voncloft/Macropad/Macropad/back.jpg

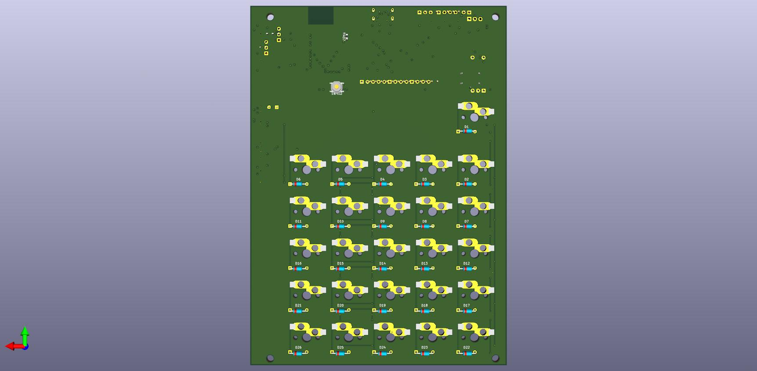
Macropad/back.jpg
