voncloft/Macropad/README.md

Hopefully a simple project to push thru on March 31st 2026

A macropad with Wifi, Bluetooth, IR TX and RX, and battery operated
