voncloft/Macropad/Macropad/REV_B_PIN_ASSIGNMENT.txt

REV-B Proposed Pin Assignment (First Pass)
Generated: 2026-03-01

RGB data in: pad 23 (existing signal now named RGB_DATA) -> net RGB_DATA
Hall analog in: pad 35 (currently NC) -> net HALL_OUT
Display bus: keep existing LCD_MOSI/LCD_SCLK nets on pads 33/34
LCD control: pads 36/37/38/39 -> LCD_CS/LCD_DC/LCD_RST/LCD_BL
Touch (I2C, repurposed from old SPI-touch nets): pad 24 -> TOUCH_SDA, pad 26 -> TOUCH_SCL
Shared SPI MISO return: pad 25 -> SPI_MISO
SD card (shared SPI): pad 27 -> SD_CS
Encoder: keep existing ENC_A/ENC_B/ENC_SW on pads 30/31/32

Reserved NC pads for future use: 8, 9, 10, 11, 13, 14, 15, 16

Notes
- Final GPIO legality must be cross-checked against ESP32-S3 strapping/boot constraints.
- Display + SD shared SPI bus plan:
- SD card: SCK=LCD_SCLK, MOSI=LCD_MOSI, MISO=SPI_MISO, CS=SD_CS.
- Touch controller (#2090 I2C): SDA=TOUCH_SDA, SCL=TOUCH_SCL.
- If pad 35 ADC mapping is unsuitable, move hall to one of: 8, 9, 10, 11, 13, 14, 15, 16.
- Power/current firmware limits must be enabled before high-brightness RGB tests.
