voncloft/Macropad/case/keyboard-layout.png

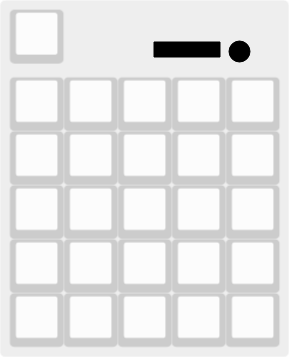
case/keyboard-layout.png
