voncloft/Macropad/case/Screenshot_20260228_230614.png

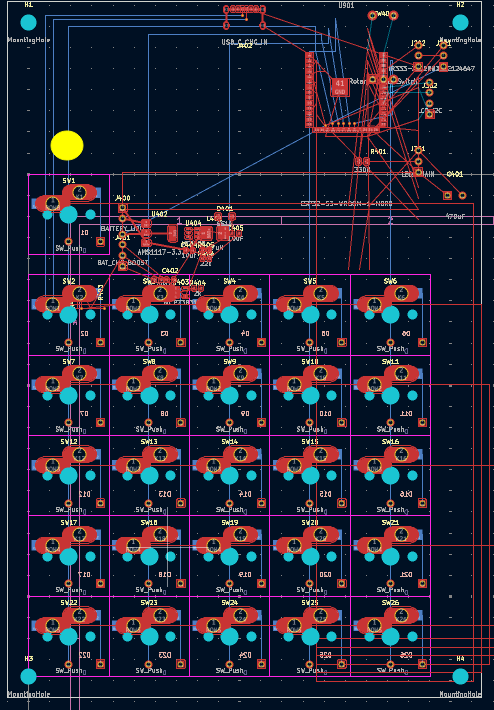
case/Screenshot_20260228_230614.png
