voncloft/Macropad/Macropad/live_board_render.png

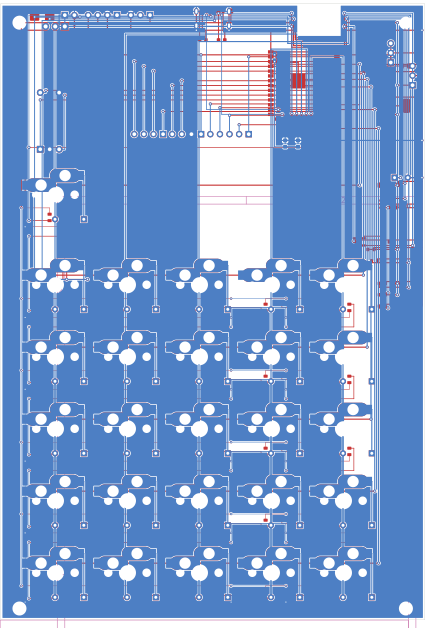
Macropad/live_board_render.png
