voncloft/Macropad/macropad.ods

Sheet: Parts
Category | Part | Qty | Unit Price (USD) | Line Total (USD) | URL | Notes
Required | Cherry MX Switch Set (35 switches) | 1 | 19.99 | 19.99 | https://www.keychron.com/products/cherry-switch-set | Hot-swap switches for 26-key build (buy 1x 35-pack)
Required | DSA Clear 1U Blank Keycap Set (10 pcs) | 3 | 5.7 | 17.1 | https://shop.beekeeb.com/product/dsa-clear-1u-blank-keycap-set-for-mx-switch/ | 3 packs gives 30 keys for 26-key build; flat DSA profile
Required | OLED LCD module (0.91in, 128x32, I2C) | 1 | 34.95 | 34.95 | https://www.adafruit.com/product/2090 | Matches display spec in project notes
Required | LiPo battery 3.7V 2500mAh | 1 | 14.95 | 14.95 | https://www.adafruit.com/product/328 | Power pack for portable build
Required | MSS-102545-14A-V-SMT mini slide switch | 1 | 1.88 | 1.88 | https://www.digikey.com/en/products/detail/same-sky-formerly-cui-devices/MSS-102545-14A-V-SMT/13978953 | Inline battery power switch
Required | Rotary knob, 6mm D-shaft compatible | 1 | 2.95 | 2.95 | https://www.adafruit.com/product/5531 | Fits 6mm shaft rotary encoder with set screw
Required | M3 screw + standoff kit | 1 | 16.95 | 16.95 | https://www.adafruit.com/product/4685 | Case/board mounting hardware
Required | 22AWG stranded hookup wire set (6 x 25ft) | 1 | 19.95 | 19.95 | https://www.adafruit.com/product/3111 | Battery/switch/LCD wiring
Required | Solder spool (100g) | 1 | 14.95 | 14.95 | https://www.adafruit.com/category/product/145 | Through-hole and wire soldering
Required | USB-C to USB-C cable, 3ft | 1 | 3.88 | 3.88 | https://www.walmart.com/ip/ONN-TYPE-C-CABLE/14834760762 | Power/data cable
Required | Adjustable 30W 110V soldering iron | 1 | 22 | 22 | https://www.newark.com/adafruit/180/adjustable-30w-110v-soldering/dp/54W2651 | For assembly and wiring
Required | Soldering Kit (iron + stand + tips + wick + sucker + tweezers + flux) | 1 | 29.99 | 29.99 | https://www.amazon.com/dp/B07Q2B4ZY9 | Complete kit for assembly/rework (replace separate iron if preferred)
Optional | Digital multimeter | 1 | 17.5 | 17.5 | https://www.adafruit.com/product/2034 | Voltage/continuity checks during bring-up
Required | 3mm LEDs (diffused) | 30 | 0.2 | 6 | https://www.adafruit.com/product/777 | Adafruit 3mm diffused red LEDs: $4.95 per 25-pack (~$0.198 each)
Required | Pin pusher for reset | 1 | 9.2 | 9.2 | https://www.centurytools.com/product/press-fit-spring-plunger-27/
 | Male to female jumpers | 1 | 1.51 | 1.51 | https://www.aliexpress.us/item/2251832638768791.html?src=google

Sheet: JLCPCB
JLCPCB Item | Qty | Est Unit (USD) | Line Total (USD) | URL | Notes
PCB fabrication (5 pcs, 2-layer) | 1 | 24 | 24 | https://jlcpcb.com/quote | PCB fab by JLCPCB
PCBA assembly add | 1 | 200 | 200 | https://jlcpcb.com/pcb-assembly | User-requested +200 assembly
ESP32-S3-WROOM-1 module | 1 | 4.9 | 4.9 | https://www.lcsc.com/product-detail/C2913201.html | Main MCU
Kailh hotswap socket | 26 | 0.11 | 2.86 | https://www.lcsc.com/product-detail/C41430893.html | Onboard sockets
Diode DO-35 | 26 | 0.02 | 0.52 | https://www.lcsc.com/product-detail/C85057.html | Matrix diodes
Resistor 0603 | 5 | 0.01 | 0.05 | https://www.lcsc.com/product-detail/C25803.html | From footprint count
Resistor 0805 | 1 | 0.01 | 0.01 | https://www.lcsc.com/product-detail/C17630.html | From footprint count
Capacitor 0603 | 4 | 0.01 | 0.04 | https://www.lcsc.com/product-detail/C19702.html | From footprint count
SOD-123 diode | 1 | 0.03 | 0.03 | https://www.lcsc.com/product-detail/C2480.html | Power path
Inductor 5x5 | 1 | 0.28 | 0.28 | https://www.lcsc.com/product-detail/C354596.html | Boost section
Electrolytic cap radial | 1 | 0.12 | 0.12 | https://www.lcsc.com/product-detail/C3035350.html | Power filtering
SOT-223 | 1 | 0.15 | 0.15 | https://www.lcsc.com/product-detail/C6186.html | Power IC/transistor
SOT-23-5 | 1 | 0.09 | 0.09 | https://www.lcsc.com/product-detail/C424093.html | Power/control
SOT-23-6 | 1 | 0.08 | 0.08 | https://www.lcsc.com/product-detail/C84817.html | Power/control
USB-C receptacle | 1 | 0.48 | 0.48 | https://www.lcsc.com/product-detail/C3151650.html | USB connector
Pin headers total (includes IR module mounts) | 6 | 0.25 | 1.5 | https://www.lcsc.com/product-detail/C49257.html | 1x2/1x3/1x4 total
Rotary encoder EC11 | 1 | 0.65 | 0.65 | https://www.lcsc.com/product-detail/C361165.html | Onboard encoder

Sheet: Summary
Summary Item | Value (USD) | Notes
Parts Autosum | 233.75 | Excel-style pull from Parts autosum label
JLCPCB Autosum | 235.76 | Excel-style pull from JLCPCB autosum label
Autosum (Summary Page) | 469.51 | Final total
Switch Wiring Note | Solder required | Battery+ -> switch -> BAT+, battery- direct to GND
