voncloft/Macropad/case_reworking/macropad_case_assembled.stl

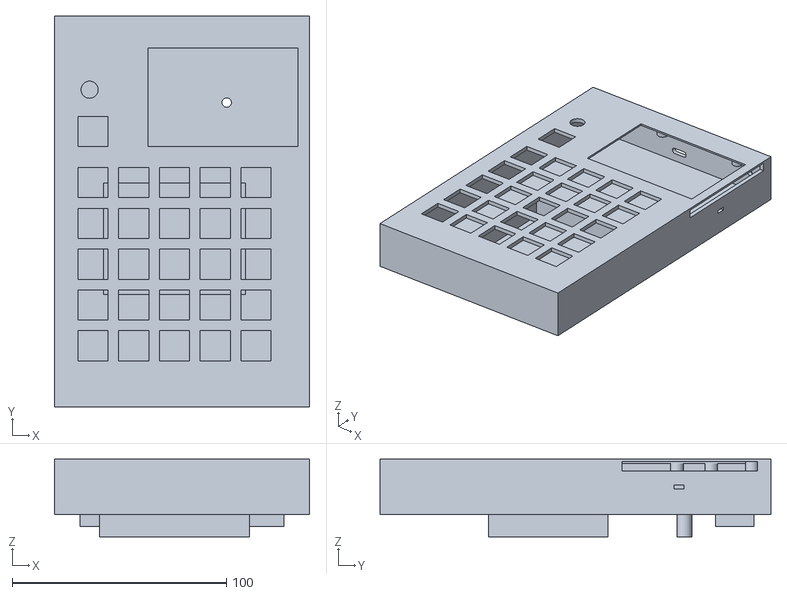
[picture p5: CAD file, 2026-03-06]
case_reworking/macropad_case_assembled.stl
119.1 x 182.5 x 36.4
