voncloft/Macropad/case/macropad_case_assembled.stl

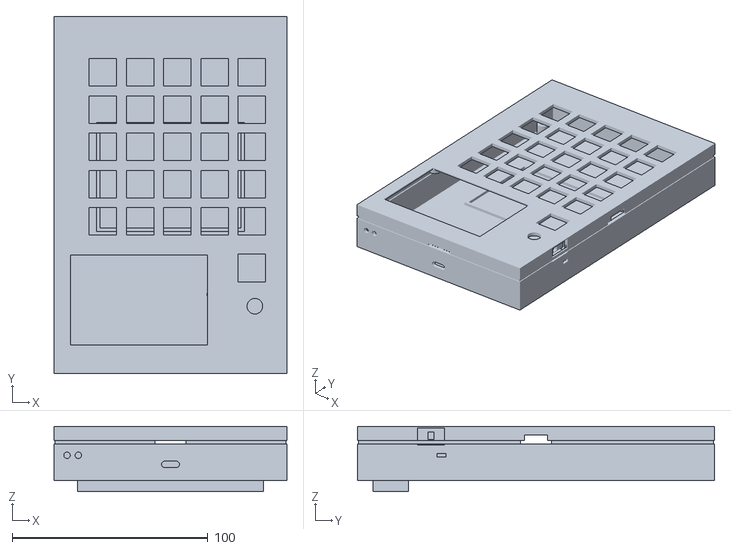
[picture p6: CAD file, 2026-03-04]
case/macropad_case_assembled.stl
119.1 x 182.5 x 33.4
