voncloft/Macropad/case/macropad_case_side_by_side.stl

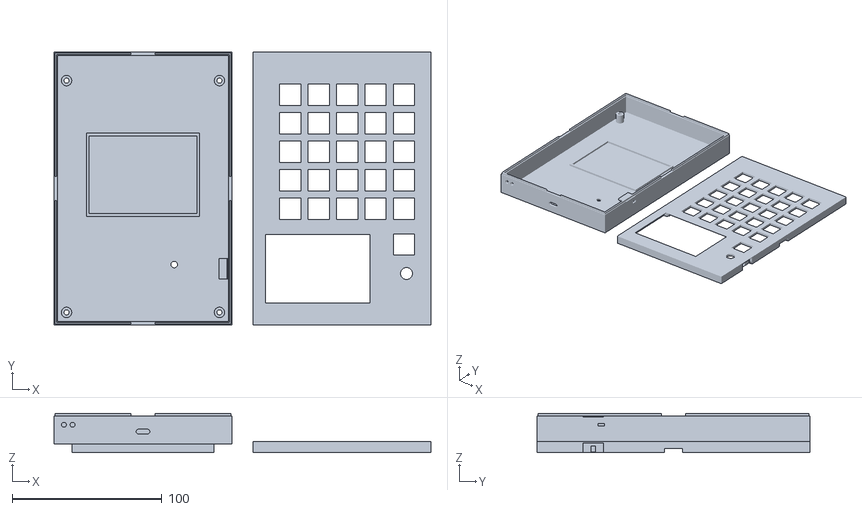
[picture p7: CAD file, 2026-03-04]
case/macropad_case_side_by_side.stl
252.1 x 182.5 x 26.1
