voncloft/Macropad/case_reworking/macropad_case_pcb_preview.stl

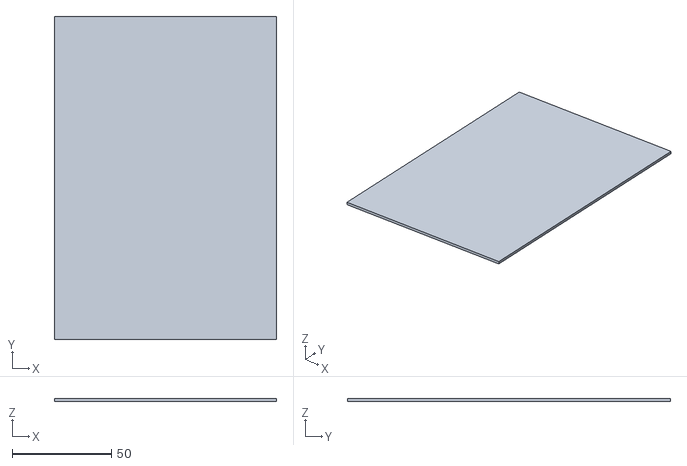
[picture p8: CAD file, 2026-03-06]
case_reworking/macropad_case_pcb_preview.stl
112.3 x 163.0 x 1.60
