voncloft/Macropad/case/macropad_case_bottom_with_pcb_exploded_preview.stl

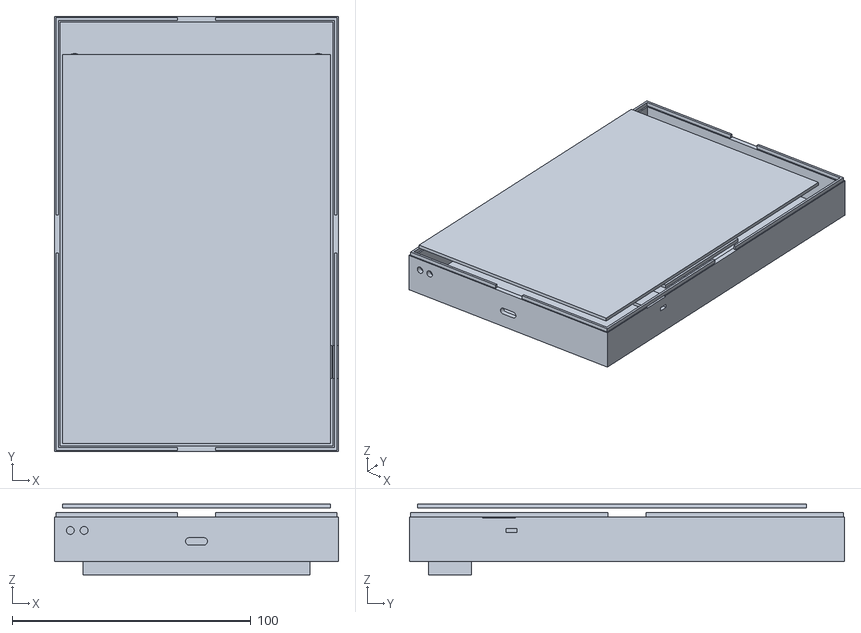
[picture p9: CAD file, 2026-03-04]
case/macropad_case_bottom_with_pcb_exploded_preview.stl
119.1 x 182.5 x 29.6
