voncloft/Macropad/case/macropad_case_bottom.stl

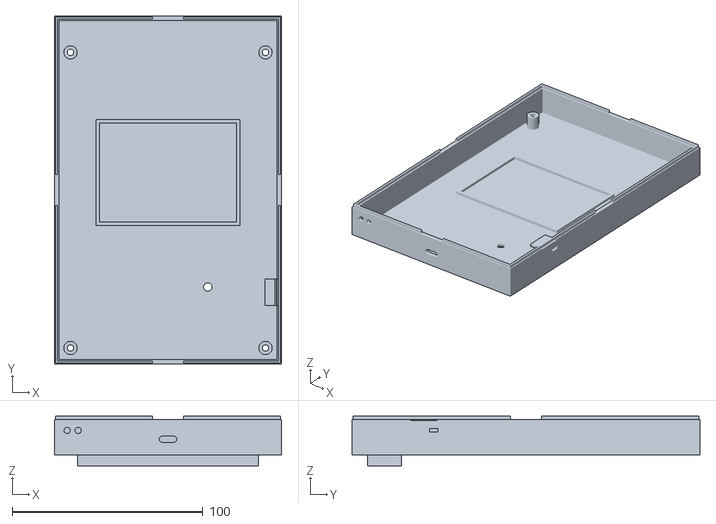
[picture p10: CAD file, 2026-03-04]
case/macropad_case_bottom.stl
119.1 x 182.5 x 26.1
