voncloft/Macropad/case_reworking/macropad_case_bottom.stl

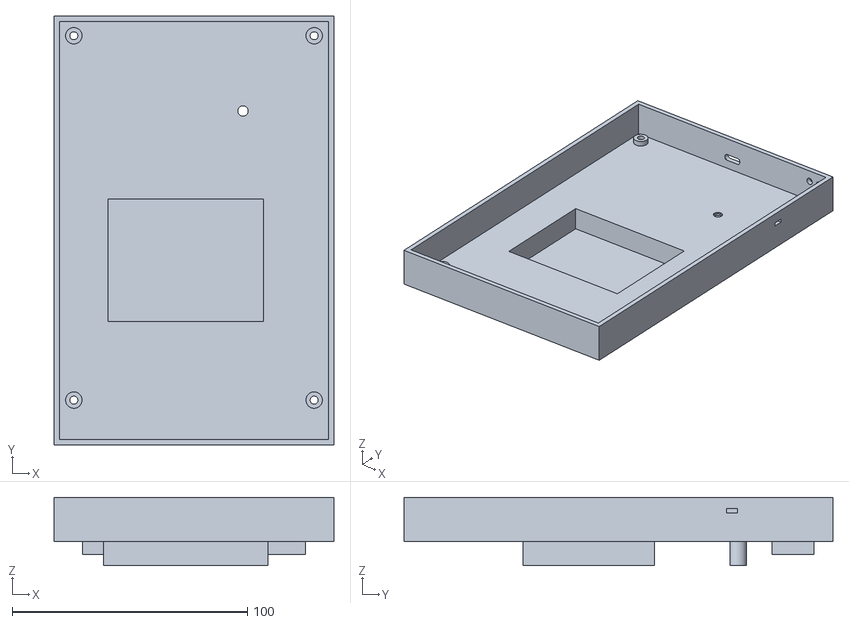
[picture p11: CAD file, 2026-03-06]
case_reworking/macropad_case_bottom.stl
119.1 x 182.5 x 29.1
