voncloft/Macropad/case_reworking/macropad_case_preview.FCStd

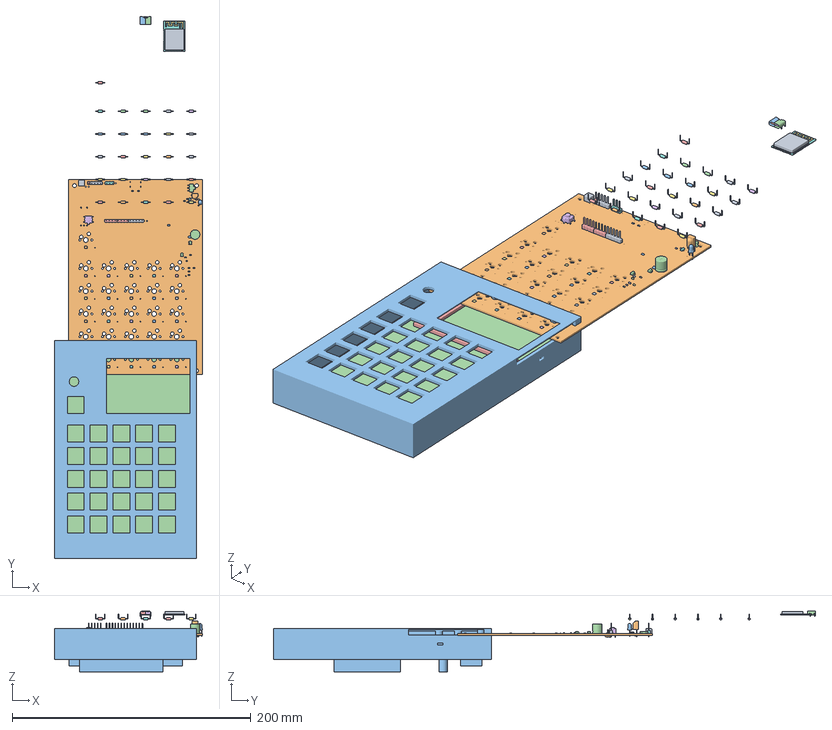
[picture p13: CAD file, 2026-03-06]
case_reworking/macropad_case_preview.FCStd
124.1 x 453.8 x 50.8 mm
R_0603_1608Metric
LED_RGB_1210
LED_D3.0mm
CP_Radial_D8.0mm_P3.50mm
LED_RGB_1211
LED_RGB_1212
LED_RGB_1213
LED_RGB_1214
C_0603_1608Metric
LED_RGB_1215
LED_RGB_1216
SOT-23-5
PinHeader_1x04_P2.54mm_Vertical
C_0603_1608Metric001
LED_RGB_1217
PinHeader_1x03_P2.54mm_Vertical
LED_RGB_1218
R_0603_1608Metric001
LED_RGB_1219
SOT-23-6
PinHeader_1x02_P2.54mm_Vertical
LED_RGB_1220
C_0603_1608Metric002
SOT-23
L_APV_ANR5040
LED_RGB_1221
R_0805_2012Metric
LED_RGB_1222
LED_RGB_1223
R_0603_1608Metric002
C_0603_1608Metric003
LED_RGB_1224
LED_RGB_1225
R_0805_2012Metric001
LED_RGB_1226
R_0603_1608Metric003
USB_C_Receptacle_GCT_USB4125-xx-x_6P_TopMnt_Horizontal
USB_C_Receptacle_GCT_USB4125-xx-x_6P_TopMnt_Horizontal001
USB_C_Receptacle_GCT_USB4125-xx-x_6P_TopMnt_Horizontal002
USB_C_Receptacle_GCT_USB4125-xx-x_6P_TopMnt_Horizontal003
USB_C_Receptacle_GCT_USB4125-xx-x_6P_TopMnt_Horizontal004
USB_C_Receptacle_GCT_USB4125-xx-x_6P_TopMnt_Horizontal005
USB_C_Receptacle_GCT_USB4125-xx-x_6P_TopMnt_Horizontal006
USB_C_Receptacle_GCT_USB4125-xx-x_6P_TopMnt_Horizontal007
USB_C_Receptacle_GCT_USB4125-xx-x_6P_TopMnt_Horizontal008
USB_C_Receptacle_GCT_USB4125-xx-x_6P_TopMnt_Horizontal009
USB_C_Receptacle_GCT_USB4125-xx-x_6P_TopMnt_Horizontal010
USB_C_Receptacle_GCT_USB4125-xx-x_6P_TopMnt_Horizontal011
USB_C_Receptacle_GCT_USB4125-xx-x_6P_TopMnt_Horizontal012
USB_C_Receptacle_GCT_USB4125-xx-x_6P_TopMnt_Horizontal013
USB_C_Receptacle_GCT_USB4125-xx-x_6P_TopMnt_Horizontal014
USB_C_Receptacle_GCT_USB4125-xx-x_6P_TopMnt_Horizontal015
PinHeader_1x04_P2.54mm_Vertical001
LED_RGB_1227
LED_RGB_1228
LED_RGB_1229
PinHeader_1x05_P2.54mm_Vertical
Vishay_MINICAST-3Pin
D_SOD-123
SOT-223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
