voncloft/Macropad/case/macropad_case_top.stl

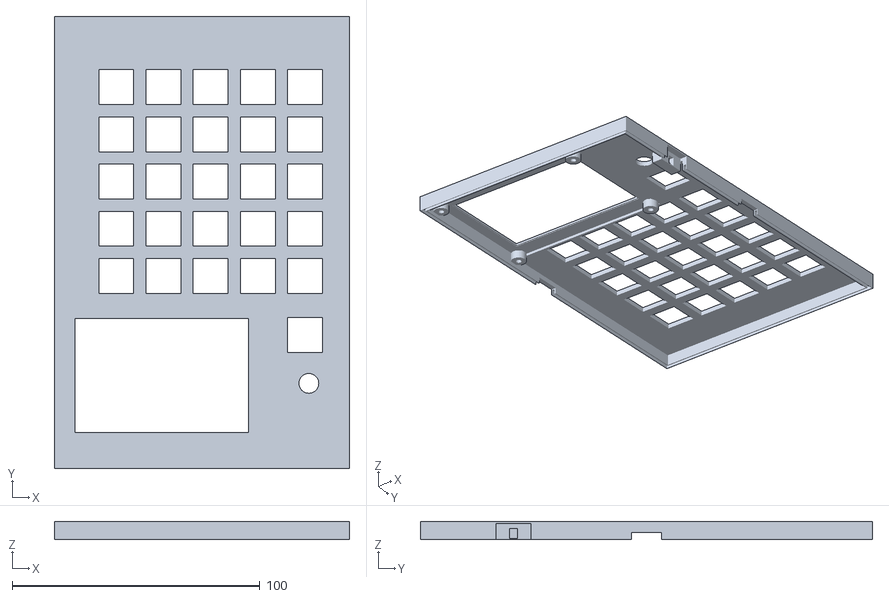
[picture p14: CAD file, 2026-03-04]
case/macropad_case_top.stl
119.1 x 182.5 x 7.28
