voncloft/Macropad/case_reworking/macropad_oled_retainer.stl

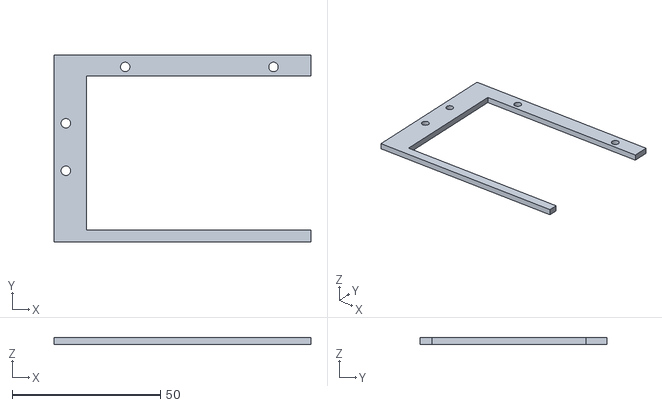
[picture p15: CAD file, 2026-03-06]
case_reworking/macropad_oled_retainer.stl
86.6 x 63.0 x 2.40
