voncloft/Macropad/case_reworking/macropad_case_side_by_side.stl

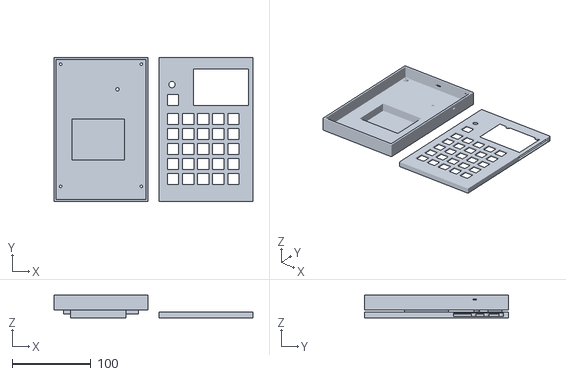
[picture p16: CAD file, 2026-03-06]
case_reworking/macropad_case_side_by_side.stl
252.1 x 182.5 x 29.1
