voncloft/Macropad/case/macropad_case_lcd_retainer_plate.stl

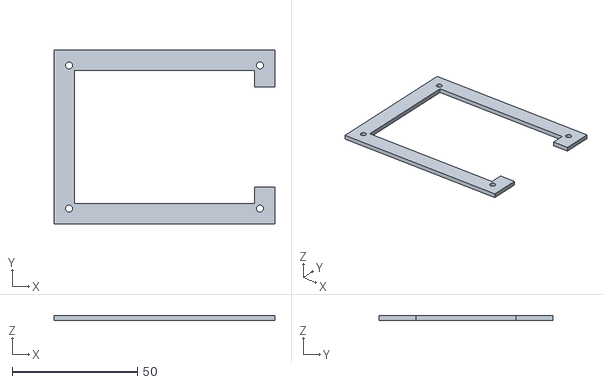
[picture p17: CAD file, 2026-03-04]
case/macropad_case_lcd_retainer_plate.stl
88.3 x 69.5 x 2.00
