voncloft/Macropad/case_reworking/macropad_case_top.stl

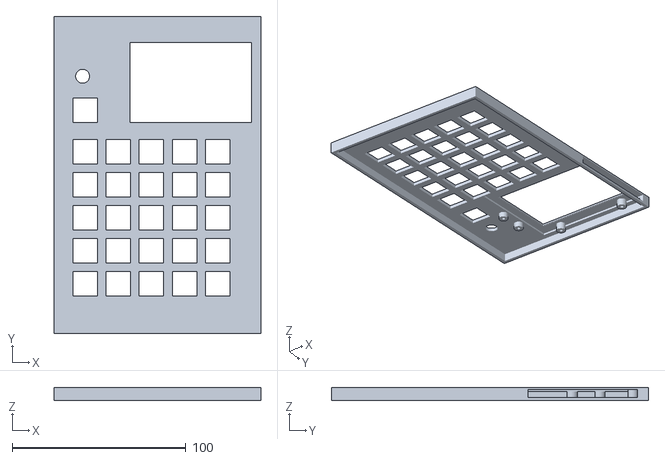
[picture p18: CAD file, 2026-03-06]
case_reworking/macropad_case_top.stl
119.1 x 182.5 x 7.28
