voncloft/Macropad/case/macropad_case_pcb_driven.stl

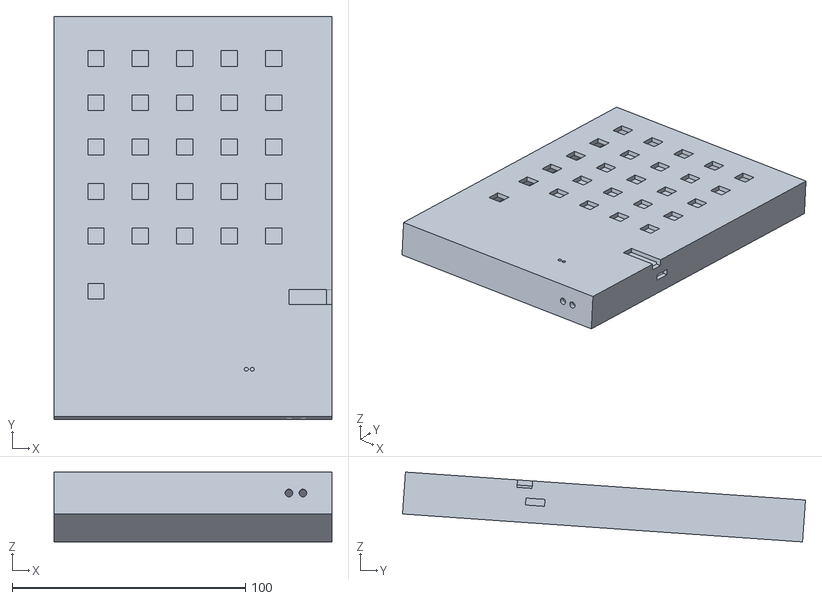
[picture p19: CAD file, 2026-03-01]
case/macropad_case_pcb_driven.stl
119.1 x 172.7 x 29.9
