voncloft/Macropad/Macropad/Macropad.kicad_pcb

## KiCad design Macropad/Macropad.kicad_pcb (2026-03-18)

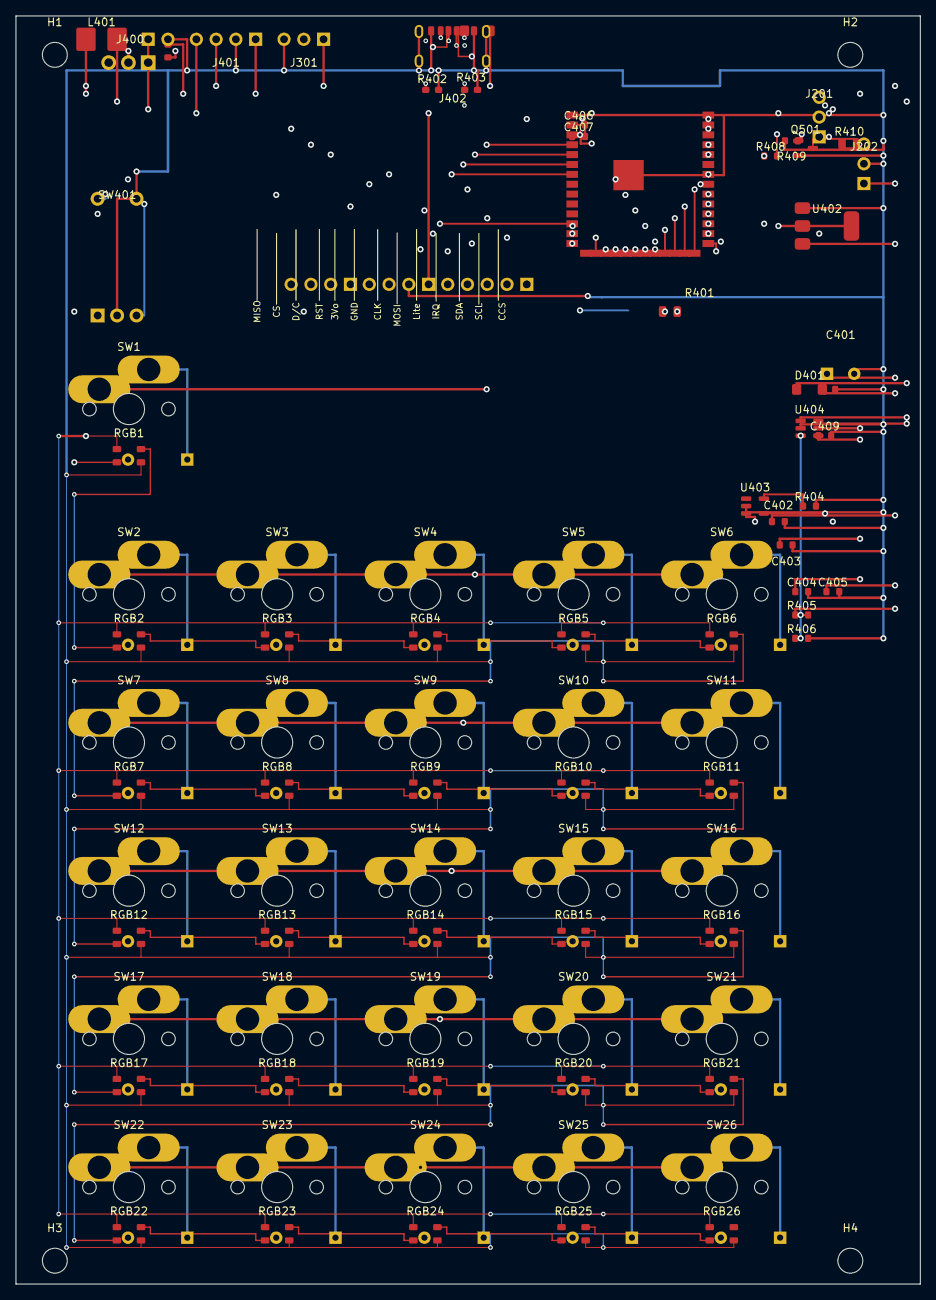
[picture p20: board Macropad.kicad_pcb from above]

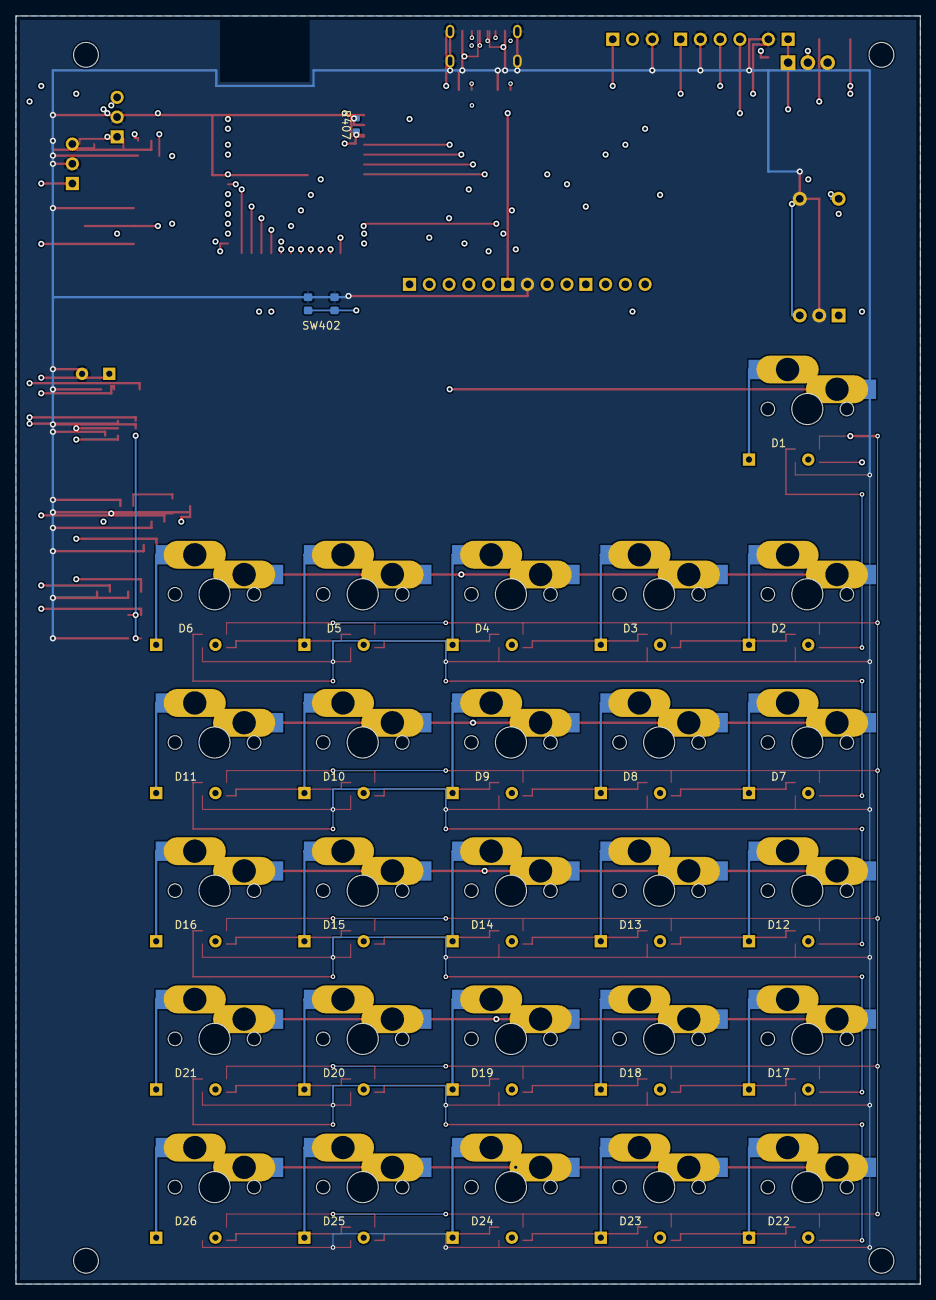
[picture p21: board Macropad.kicad_pcb from below]

Board: 4 copper layers, 116.2 x 163.0 mm, 122 parts (28 on the bottom side), 98 nets.

Parts:
C401: 470uF; GEN_CP_Radial_D8_P3.5
C402: 1uF; C_0603_1608Metric_LOCAL
C403: 4.7uF; C_0603_1608Metric_LOCAL
C404, C405, C408, C409: 10uF; C_0603_1608Metric_LOCAL
C406: 100nF; C_0603_1608Metric_LOCAL
C407: 22uF; C_0603_1608Metric_LOCAL
D1, D2, D3, D4, D5, D6, D7, D8, D9, D10, D11, D12, D13, D14, D15, D16, D17, D18, D19, D20, D21, D22, D23, D24, D25, D26: D; D_DO35_Custom
D401: SS14; D_SOD123_LOCAL
D402: SS14_VBUS_TO_5VSYS; D_SOD123_LOCAL
F401: PTC_0.5A; R_0603_1608Metric_LOCAL
H1, H2, H3, H4: MountingHole; GEN_MountingHole_3.2mm_M3
J201: TSOP4838_C124647; GEN_PinHeader_1x3_P2.54
J202: IR_LED_TX_HDR; GEN_PinHeader_1x3_P2.54
J301: LED_CHAIN; GEN_PinHeader_1x3_P2.54
J302: LCD_SPI_PWRDATA; GEN_PinHeader_1x4_P2.54
J303: LCD_SPI_CTRL; GEN_PinHeader_1x4_P2.54
J304: TOUCH_I2C_SD_IRQ; GEN_PinHeader_1x5_P2.54
J400: BATTERY_LIPO; GEN_PinHeader_1x2_P2.54
J401: BAT_CHG_BOOST; GEN_PinHeader_1x4_P2.54
J402: USB_C_CHG_IN; USB_C_Receptacle_GCT_USB4125_6P_LOCAL
L401: 4.7uH; L_Boost_5x5_LOCAL
Q501: AO3400A; SOT-23_LOCAL
R401: 330R; R_0805_2012Metric_LOCAL
R402, R403: 5.1k; R_0603_1608Metric_LOCAL
R404: 3.3k; R_0603_1608Metric_LOCAL
R405: 162k; R_0603_1608Metric_LOCAL
R406: 22k; R_0603_1608Metric_LOCAL
R407: 10k; R_0603_1608Metric_LOCAL
R408: 100R; R_0603_1608Metric_LOCAL
R409: 100k; R_0603_1608Metric_LOCAL
R410: 47R; R_0805_2012Metric_LOCAL
RGB1, RGB2, RGB3, RGB4, RGB5, RGB6, RGB7, RGB8, RGB9, RGB10, RGB11, RGB12, RGB13, RGB14, RGB15, RGB16, RGB17, RGB18, RGB19, RGB20, RGB21, RGB22, RGB23, RGB24, RGB25, RGB26: SK6812MINI; RGB_PLACEHOLDER_3535
SW1, SW2, SW3, SW4, SW5, SW6, SW7, SW8, SW9, SW10, SW11, SW12, SW13, SW14, SW15, SW16, SW17, SW18, SW19, SW20, SW21, SW22, SW23, SW24, SW25, SW26: SW_Push; Kailh_Hotswap_MX_1U_Custom
SW401: RotaryEncoder_Switch; GEN_RotaryEncoder_EC11_Switch
SW402: MSS-102545-14A-V-SMT; SW_Slide_SPDT_BATTERY_KILL_MSS-102545-14A-V-SMT_LOCAL
SW402#2: SW_Push; SW_TACT_3x6_4P_LOCAL
U402: AP7361C-33E; SOT-223-3_TabPin2_LOCAL
U403: MCP73831; SOT-23-5_LOCAL
U404: MT3608; SOT-23-6_LOCAL
U901: ESP32-S3-WROOM-1-N8R8; ESP32-S3-WROOM-1_LOCAL

Connections:
3V3: C406.1, C407.1, J201.1, J302.1, J401.4, R407.2, U402.2, U901.2
5V_SYS: C401.1, C402.1, C405.1, C408.1, D401.2, D402.2, J202.1, J301.1, J401.3, R405.1, RGB1.1, RGB2.1, RGB3.1, RGB4.1, RGB5.1, RGB6.1, RGB7.1, RGB8.1, RGB9.1, RGB10.1, RGB11.1, RGB12.1, RGB13.1, RGB14.1, RGB15.1, RGB16.1, RGB17.1, RGB18.1, RGB19.1, RGB20.1, RGB21.1, RGB22.1, RGB23.1, RGB24.1, RGB25.1, RGB26.1, U402.3
BAT+: C403.1, C404.1, C409.1, F401.2, J401.1, L401.1, U404.4, U404.5
BAT_RAW: J400.1, SW402.1, U403.3
BAT_SW: F401.1, SW402.2
BOOST_FB: R405.2, R406.1, U404.3
BOOST_SW: D401.1, L401.2, U404.1, U404.6
CHG_PROG: R404.1, U403.5
COL0: D1.2, D2.2, D7.2, D12.2, D17.2, D22.2, U901.18
COL1: D3.2, D8.2, D13.2, D18.2, D23.2, U901.19
COL2: D4.2, D9.2, D14.2, D19.2, D24.2, U901.20
COL3: D5.2, D10.2, D15.2, D20.2, D25.2, U901.21
COL4: D6.2, D11.2, D16.2, D21.2, D26.2, U901.22
EN: R407.1, SW402#2.1, U901.3
ENC_A: SW401.A, U901.30
ENC_B: SW401.B, U901.31
ENC_SW: SW401.S1, U901.32
GND: C401.2, C402.2, C403.2, C404.2, C405.2, C406.2, C407.2, C408.2, C409.2, J201.2, J202.2, J301.3, J302.2, J400.2, J401.2, J402.A12, J402.B12, J402.S1, Q501.2, R402.2, R403.2, R404.2, R406.2, R409.2, RGB1.3, RGB2.3, RGB3.3, RGB4.3, RGB5.3, RGB6.3, RGB7.3, RGB8.3, RGB9.3, RGB10.3, RGB11.3, RGB12.3, RGB13.3, RGB14.3, RGB15.3, RGB16.3, RGB17.3, RGB18.3, RGB19.3, RGB20.3, RGB21.3, RGB22.3, RGB23.3, RGB24.3, RGB25.3, RGB26.3, SW401.C, SW401.S2, SW402#2.2, U402.1, U403.2, U404.2, U901.1, U901.40, U901.41
IR_LED_K: J202.3, R410.1
IR_LED_SW: Q501.3, R410.2
IR_RX: J201.3, U901.28
IR_TX: R408.1, U901.29
IR_TX_GATE: Q501.1, R408.2, R409.1
K1: D1.1, SW1.2
K2: D2.1, SW2.2
K3: D3.1, SW3.2
K4: D4.1, SW4.2
K5: D5.1, SW5.2
K6: D6.1, SW6.2
K7: D7.1, SW7.2
K8: D8.1, SW8.2
K9: D9.1, SW9.2
K10: D10.1, SW10.2
K11: D11.1, SW11.2
K12: D12.1, SW12.2
K13: D13.1, SW13.2
K14: D14.1, SW14.2
K15: D15.1, SW15.2
K16: D16.1, SW16.2
K17: D17.1, SW17.2
K18: D18.1, SW18.2
K19: D19.1, SW19.2
K20: D20.1, SW20.2
K21: D21.1, SW21.2
K22: D22.1, SW22.2
K23: D23.1, SW23.2
K24: D24.1, SW24.2
K25: D25.1, SW25.2
K26: D26.1, SW26.2
LCD_BL: J304.1, U901.39
LCD_CS: J303.2, U901.36
LCD_DC: J303.3, U901.37
LCD_MOSI: J302.4, U901.33
LCD_RST: J303.4, U901.38
LCD_SCLK: J302.3, U901.34
LED_DIN: J301.2, R401.2, RGB1.4
RGB1_DOUT: RGB1.2, RGB2.4
RGB2_DOUT: RGB2.2, RGB3.4
RGB3_DOUT: RGB3.2, RGB4.4
RGB4_DOUT: RGB4.2, RGB5.4
RGB5_DOUT: RGB5.2, RGB6.4
RGB6_DOUT: RGB6.2, RGB7.4
RGB7_DOUT: RGB7.2, RGB8.4
RGB8_DOUT: RGB8.2, RGB9.4
RGB9_DOUT: RGB9.2, RGB10.4
RGB10_DOUT: RGB10.2, RGB11.4
RGB11_DOUT: RGB11.2, RGB12.4
RGB12_DOUT: RGB12.2, RGB13.4
RGB13_DOUT: RGB13.2, RGB14.4
RGB14_DOUT: RGB14.2, RGB15.4
RGB15_DOUT: RGB15.2, RGB16.4
RGB16_DOUT: RGB16.2, RGB17.4
RGB17_DOUT: RGB17.2, RGB18.4
RGB18_DOUT: RGB18.2, RGB19.4
RGB19_DOUT: RGB19.2, RGB20.4
RGB20_DOUT: RGB20.2, RGB21.4
RGB21_DOUT: RGB21.2, RGB22.4
RGB22_DOUT: RGB22.2, RGB23.4
RGB23_DOUT: RGB23.2, RGB24.4
RGB24_DOUT: RGB24.2, RGB25.4
RGB25_DOUT: RGB25.2, RGB26.4
RGB_DATA: R401.1, U901.23
ROW0: SW1.1, U901.4
ROW1: SW2.1, SW3.1, SW4.1, SW5.1, SW6.1, U901.5
ROW2: SW7.1, SW8.1, SW9.1, SW10.1, SW11.1, U901.6
ROW3: SW12.1, SW13.1, SW14.1, SW15.1, SW16.1, U901.7
ROW4: SW17.1, SW18.1, SW19.1, SW20.1, SW21.1, U901.12
ROW5: SW22.1, SW23.1, SW24.1, SW25.1, SW26.1, U901.17
SD_CS: J304.5, U901.27
SPI_MISO: J303.1, U901.25
TOUCH_INT: J304.2, U901.16
TOUCH_SCL: J304.4, U901.26
TOUCH_SDA: J304.3, U901.24
USB_CC1: J402.A5, R402.1
USB_CC2: J402.B5, R403.1
USB_DN: J402.A7, J402.B7, U901.13
USB_DP: J402.A6, J402.B6, U901.14
VBUS: D402.1, J402.A9, J402.B9, U403.4
