voncloft/Macropad/(commit log)

2026-02-28 FIRST UPLOAD
    [Macropad-B_Courtyard.gbr, Macropad-B_Cu.gbl, Macropad-B_Fab.gbr, Macropad-B_Mask.gbs, Macropad-B_Paste.gbp, Macropad-B_Silkscreen.gbo, Macropad-Edge_Cuts.gm1, Macropad-F_Courtyard.gbr]
2026-03-01 Project Updates
    [Macropad-B_Courtyard.gbr, Macropad-B_Cu.gbl, Macropad-B_Fab.gbr, Macropad-B_Mask.gbs, Macropad-B_Paste.gbp, Macropad-B_Silkscreen.gbo, Macropad-Edge_Cuts.gm1, Macropad-F_Courtyard.gbr]
2026-03-02 DONE DONE DONE
    [Macropad.kicad_pcb, Macropad.kicad_sch, macropad_case_assembled.stl, macropad_case_bottom.stl, macropad_case_side_by_side.stl, macropad_case_top.stl]
2026-03-02 DONE NOW
    [Macropad.kicad_pcb, Macropad.kicad_sch, macropad.ods]
2026-03-02 IR INCREASE
    [Macropad.kicad_pcb, Macropad.kicad_sch]
2026-03-03 pcb: fix battery/usb power path and charging/boost setpoints
    [Macropad.kicad_pcb]
2026-03-03 Finalize macropad firmware + schematic/pcb validation updates
    [Macropad.kicad_pcb, Macropad.kicad_sch]
2026-03-03 Sync firmware pad map to current PCB USB/touch routing
2026-03-03 Board and firmware updates
    [Macropad.kicad_pcb]
